yoganshbhalla/payl_theseus_2026/HARVEST/Readme.md

HARVEST PCB - See https://www.notion.so/uqspace/P-RV2601-HARVEST-301f47d1887680268325e2c343eff568
