yoganshbhalla/payl_theseus_2026/RILC/Readme.md

Regolith Illumination for Light-based Characterisation
Extension Board for AS7331 and AS7343 Breakout Spectrometers, containing VIS, UV, NIR LEDs and control/driver circuitry.
