yoganshbhalla/payl_theseus_2026/RILC/HARVEST_RILC_ExtBoard.kicad_pcb

## KiCad design RILC/HARVEST_RILC_ExtBoard.kicad_pcb (2026-03-03)

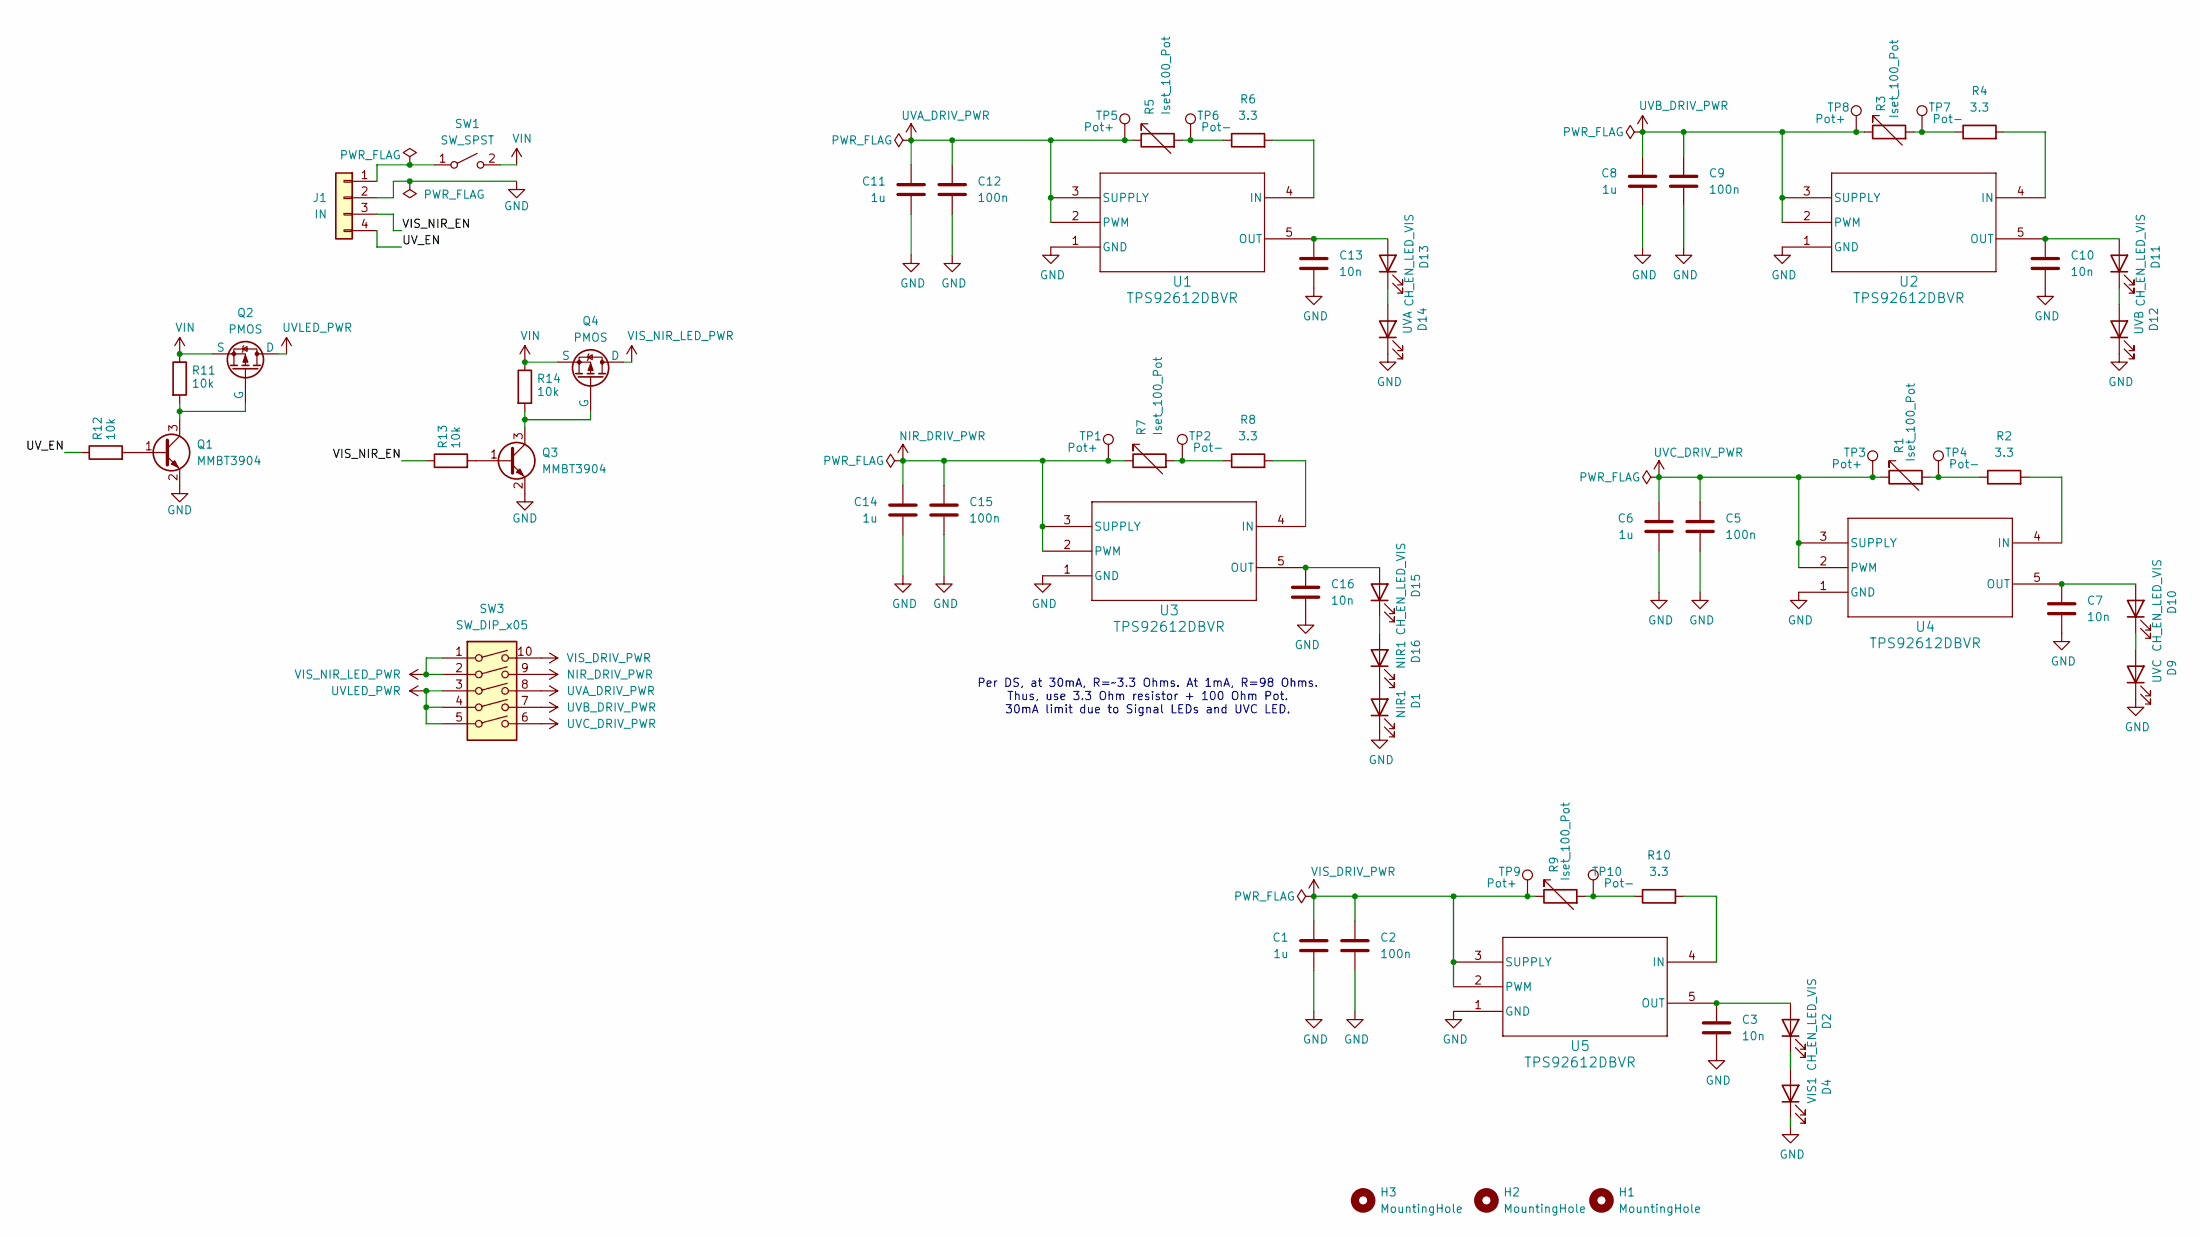
[picture p1: schematic HARVEST_RILC_ExtBoard.kicad_sch, HARVEST RILC (Reflectance Illumination LED Control) Extensi…]

Parts:
C1, C6, C8, C11, C14: 1u; C_0805_2012Metric_Pad1.18x1.45mm_HandSolder
C2, C5, C9, C12, C15: 100n; C_0805_2012Metric_Pad1.18x1.45mm_HandSolder
C3, C7, C10, C13, C16: 10n; C_0805_2012Metric_Pad1.18x1.45mm_HandSolder
D1, D16: NIR1; LED_0805_2012Metric_Pad1.15x1.40mm_HandSolder
D2, D10, D11, D13, D15: CH_EN_LED_VIS; LED_0805_2012Metric_Pad1.15x1.40mm_HandSolder
D4: VIS1; WL-SWTP_3014
D9: UVC; CR_0-275-120_VIS
D12: UVB; CHIP_1GF1A_SVI
D14: UVA; LED_0606
H1, H2, H3: MountingHole; MountingHole_2.2mm_M2
J1: IN; JST_XH_B4B-XH-A_1x04_P2.50mm_Vertical
Q1, Q3: MMBT3904; SOT-23
Q2, Q4: PMOS; SOT91P240X110-3N_DMG2305UX-7
R1, R3, R5, R7, R9: Iset_100_Pot; Potentiometer_Bourns_3296W_Vertical
R2, R4, R6, R8, R10: 3.3; R_0805_2012Metric_Pad1.20x1.40mm_HandSolder
R11, R12, R13, R14: 10k; R_0805_2012Metric_Pad1.20x1.40mm_HandSolder
SW1: SW_SPST; Switch_Toggle_SPDT_ANT11SF1CQE
SW3: SW_DIP_x05; SW_DIP_SPSTx05_Piano_CTS_Series194-5MSTN_W7.62mm_P2.54mm
TP1, TP3, TP5, TP8, TP9: Pot+; TestPoint_Pad_1.5x1.5mm
TP2, TP4, TP6, TP7, TP10: Pot-; TestPoint_Pad_1.5x1.5mm
U1, U2, U3, U4, U5: TPS92612DBVR; SOT_12DBVR_TEX

Connections:
/UV_EN: J1.4, R12.1
/VIS_NIR_EN: J1.3, R13.1
GND: C1.2, C2.2, C3.2, C5.2, C6.2, C7.2, C8.2, C9.2, C10.2, C11.2, C12.2, C13.2, C14.2, C15.2, C16.2, D1.1 (K), D4.1 (K), D9.1 (K), D12.1 (K), D14.1 (K), J1.2, Q1.2 (E), Q3.2 (E), U1.1 (GND), U2.1 (GND), U3.1 (GND), U4.1 (GND), U5.1 (GND)
NIR_DRIV_PWR: C14.1, C15.1, R7.1, SW3.9, TP1.1, U3.2 (PWM), U3.3 (SUPPLY)
unnamed: D1.2 (A), D16.1 (K)
unnamed: C3.1, D2.2 (A), U5.5 (OUT)
unnamed: D2.1 (K), D4.2 (A)
unnamed: C7.1, D10.2 (A), U4.5 (OUT)
unnamed: D9.2 (A), D10.1 (K)
unnamed: C10.1, D11.2 (A), U2.5 (OUT)
unnamed: D11.1 (K), D12.2 (A)
unnamed: C13.1, D13.2 (A), U1.5 (OUT)
unnamed: D13.1 (K), D14.2 (A)
unnamed: C16.1, D15.2 (A), U3.5 (OUT)
unnamed: D15.1 (K), D16.2 (A)
unnamed: J1.1, SW1.1 (A)
unnamed: Q1.1 (B), R12.2
unnamed: Q1.3 (C), Q2.2 (G), R11.2
unnamed: Q3.1 (B), R13.2
unnamed: Q3.3 (C), Q4.2 (G), R14.2
unnamed: R1.2, R2.1, TP4.1
unnamed: R3.2, R4.1, TP7.1
unnamed: R5.2, R6.1, TP6.1
unnamed: R7.2, R8.1, TP2.1
unnamed: R9.2, R10.1, TP10.1
unnamed: R6.2, U1.4 (IN)
unnamed: R4.2, U2.4 (IN)
unnamed: R8.2, U3.4 (IN)
unnamed: R2.2, U4.4 (IN)
unnamed: R10.2, U5.4 (IN)
UVA_DRIV_PWR: C11.1, C12.1, R5.1, SW3.8, TP5.1, U1.2 (PWM), U1.3 (SUPPLY)
UVB_DRIV_PWR: C8.1, C9.1, R3.1, SW3.7, TP8.1, U2.2 (PWM), U2.3 (SUPPLY)
UVC_DRIV_PWR: C5.1, C6.1, R1.1, SW3.6, TP3.1, U4.2 (PWM), U4.3 (SUPPLY)
UVLED_PWR: Q2.1 (D), SW3.3, SW3.4, SW3.5
VIN: Q2.3 (S), Q4.3 (S), R11.1, R14.1, SW1.2 (B)
VIS_DRIV_PWR: C1.1, C2.1, R9.1, SW3.10, TP9.1, U5.2 (PWM), U5.3 (SUPPLY)
VIS_NIR_LED_PWR: Q4.1 (D), SW3.1, SW3.2

Notes on the sheet:
Per DS, at 30mA, R=~3.3 Ohms. At 1mA, R=98 Ohms. Thus, use 3.3 Ohm resistor + 100 Ohm Pot. 30mA limit due to Signal LEDs and UVC LED.

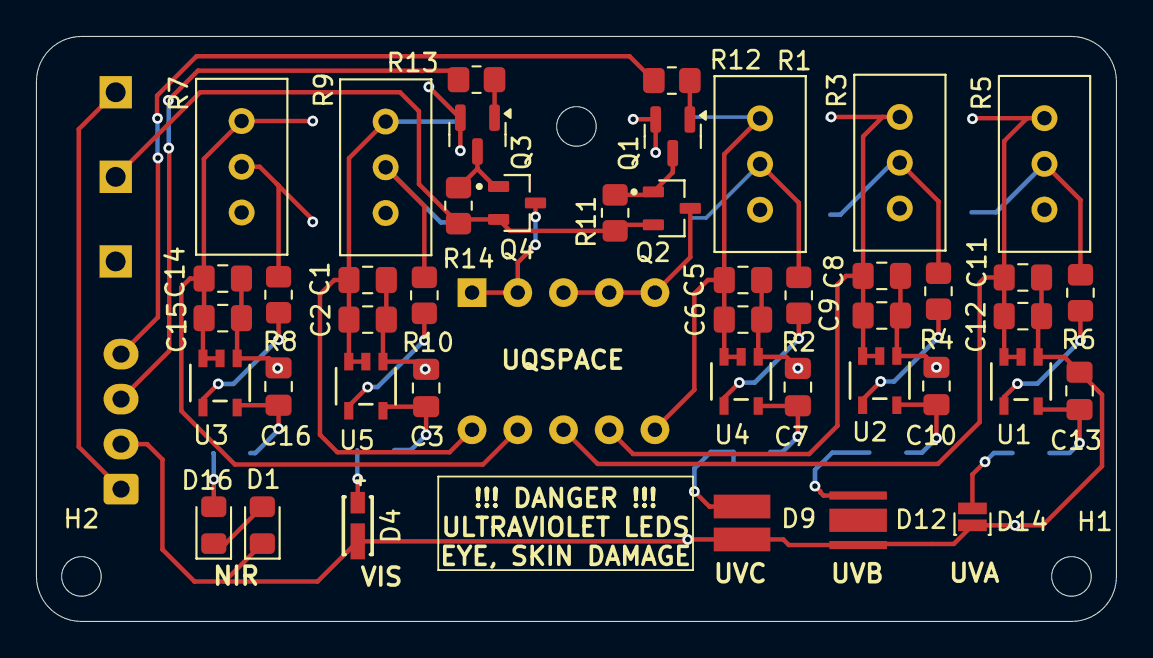
[picture p2: board HARVEST_RILC_ExtBoard.kicad_pcb from above]

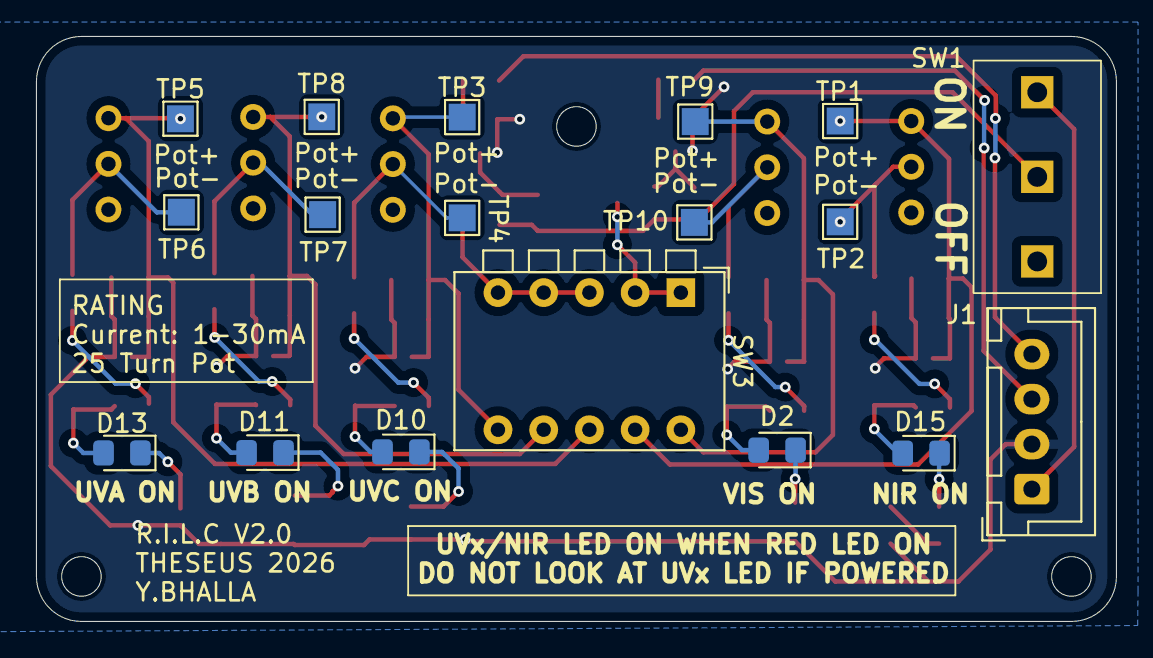
[picture p3: board HARVEST_RILC_ExtBoard.kicad_pcb from below]

Board: 2 copper layers, 60.0 x 32.5 mm, 65 parts (18 on the bottom side), 37 nets.
