yoganshbhalla/payl_theseus_2026/HARVEST/UQS_Theseus_HARVEST_Control_Boad.kicad_pcb

## KiCad design HARVEST/UQS_Theseus_HARVEST_Control_Boad.kicad_pcb (2026-03-03)

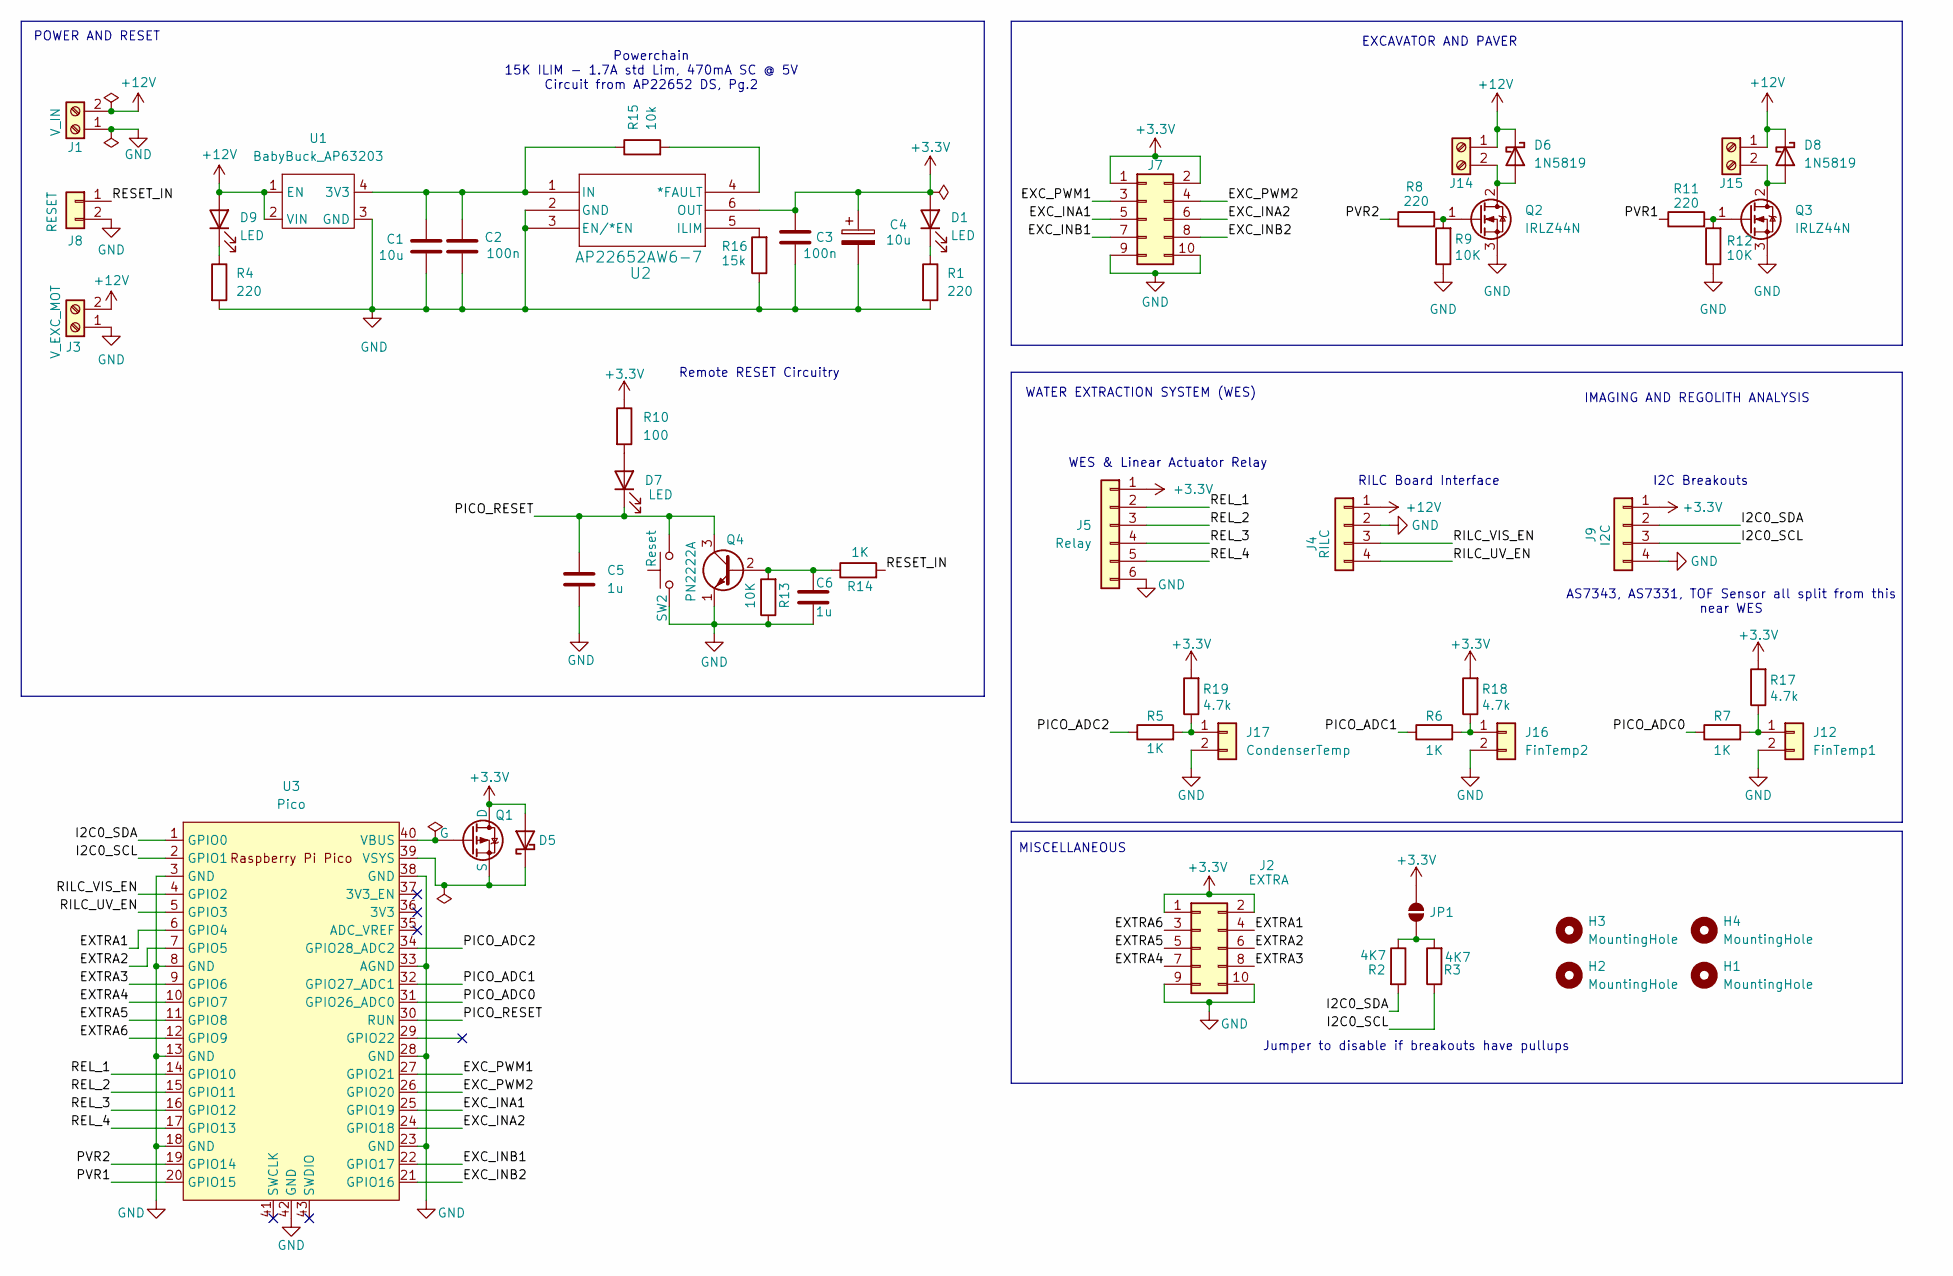
[picture p4: schematic UQS_Theseus_HARVEST_Control_Boad.kicad_sch, UQS H.A.R.V.E.S.T PCB]

Parts:
C1: 10u; C_0805_2012Metric_Pad1.18x1.45mm_HandSolder
C2, C3: 100n; C_0805_2012Metric_Pad1.18x1.45mm_HandSolder
C4: 10u; CP_Radial_D6.3mm_P2.50mm
C5, C6: 1u; C_0805_2012Metric_Pad1.18x1.45mm_HandSolder
D1, D7, D9: LED; LED_0805_2012Metric_Pad1.15x1.40mm_HandSolder
D5: D_Schottky; D_0805_2012Metric_Pad1.15x1.40mm_HandSolder
D6, D8: 1N5819; D_DO-41_SOD81_P10.16mm_Horizontal
H1, H2, H3, H4: MountingHole; MountingHole_3.2mm_M3
J1: V_IN; AMASS_XT30U-M_1x02_P5.0mm_Vertical
J2: EXTRA; PinHeader_2x05_P2.54mm_Vertical
J3: V_EXC_MOT; AMASS_XT30U-M_1x02_P5.0mm_Vertical
J4: RILC; JST_XH_B4B-XH-A_1x04_P2.50mm_Vertical
J5: Relay; JST_XH_B6B-XH-A_1x06_P2.50mm_Vertical
J7: MotorDriverSig; PinHeader_2x05_P2.54mm_Vertical
J8: RESET; PinHeader_1x02_P2.54mm_Vertical
J9: I2C; JST_XH_B4B-XH-A_1x04_P2.50mm_Vertical
J12: FinTemp1; JST_XH_B2B-XH-A_1x02_P2.50mm_Vertical
J14, J15: Screw_Terminal_01x02; TerminalBlock_RND_205-00012_1x02_P5.00mm_Horizontal
J16: FinTemp2; JST_XH_B2B-XH-A_1x02_P2.50mm_Vertical
J17: CondenserTemp; JST_XH_B2B-XH-A_1x02_P2.50mm_Vertical
JP1: SolderJumper_2_Open; SolderJumper-2_P1.3mm_Open_RoundedPad1.0x1.5mm
Q1: PMOS; SOT91P240X110-3N_DMG2305UX-7
Q2, Q3: IRLZ44N; TO-220-3_Vertical
Q4: PN2222A; TO-92_Inline
R1, R4, R8, R11: 220; R_0805_2012Metric_Pad1.20x1.40mm_HandSolder
R2, R3: 4K7; R_0805_2012Metric_Pad1.20x1.40mm_HandSolder
R5, R6, R7, R14: 1K; R_0805_2012Metric_Pad1.20x1.40mm_HandSolder
R9, R12, R13: 10K; R_0805_2012Metric_Pad1.20x1.40mm_HandSolder
R10: 100; R_0805_2012Metric_Pad1.20x1.40mm_HandSolder
R15: 10k; R_0805_2012Metric_Pad1.20x1.40mm_HandSolder
R16: 15k; R_0805_2012Metric_Pad1.20x1.40mm_HandSolder
R17, R18, R19: 4.7k; R_0805_2012Metric_Pad1.20x1.40mm_HandSolder
SW2: Reset; SW_PUSH_6mm_H4.3mm
U1: BabyBuck_AP63203; PinHeader_1x04_P2.54mm_Vertical
U2: AP22652AW6-7; AP22652A-M
U3: Pico; RPi_Pico_SMD_TH

Connections:
+3.3V: C3.1, C4.1, D1.2 (A), D5.2 (A), J2.1, J2.2, J5.1, J7.1, J7.2, J9.1, JP1.2 (B), Q1.1 (D), R10.1, R17.2, R18.2, R19.2, U2.6 (OUT)
+12V: D6.1 (K), D8.1 (K), D9.2 (A), J1.2, J3.2, J4.1, J14.1, J15.1, U1.1 (EN), U1.2 (VIN)
/EXC_INA1: J7.5, U3.25 (GPIO19)
/EXC_INA2: J7.6, U3.24 (GPIO18)
/EXC_INB1: J7.7, U3.22 (GPIO17)
/EXC_INB2: J7.8, U3.21 (GPIO16)
/EXC_PWM1: J7.3, U3.27 (GPIO21)
/EXC_PWM2: J7.4, U3.26 (GPIO20)
/EXTRA1: J2.4, U3.6 (GPIO4)
/EXTRA2: J2.6, U3.7 (GPIO5)
/EXTRA3: J2.8, U3.9 (GPIO6)
/EXTRA4: J2.7, U3.10 (GPIO7)
/EXTRA5: J2.5, U3.11 (GPIO8)
/EXTRA6: J2.3, U3.12 (GPIO9)
/I2C0_SCL: J9.3, R3.1, U3.2 (GPIO1)
/I2C0_SDA: J9.2, R2.2, U3.1 (GPIO0)
/PICO_ADC0: R7.1, U3.31 (GPIO26_ADC0)
/PICO_ADC1: R6.1, U3.32 (GPIO27_ADC1)
/PICO_ADC2: R5.1, U3.34 (GPIO28_ADC2)
/PICO_RESET: C5.1, D7.1 (K), Q4.3 (C), SW2.2, U3.30 (RUN)
/PVR1: R11.1, U3.20 (GPIO15)
/PVR2: R8.1, U3.19 (GPIO14)
/REL_1: J5.2, U3.14 (GPIO10)
/REL_2: J5.3, U3.15 (GPIO11)
/REL_3: J5.4, U3.16 (GPIO12)
/REL_4: J5.5, U3.17 (GPIO13)
/RESET_IN: J8.1, R14.2
/RILC_UV_EN: J4.4, U3.5 (GPIO3)
/RILC_VIS_EN: J4.3, U3.4 (GPIO2)
GND: C1.2, C2.2, C3.2, C4.2, C5.2, C6.2, J1.1, J2.9, J2.10, J3.1, J4.2, J5.6, J7.9, J7.10, J8.2, J9.4, J12.2, J16.2, J17.2, Q2.3 (S), Q3.3 (S), Q4.1 (E), R1.2, R4.2, R9.1, R12.1, R13.1, R16.1, SW2.1, U1.3 (GND), U2.2 (GND), U2.3 (EN/*EN), U3.3 (GND), U3.8 (GND), U3.13 (GND), U3.18 (GND), U3.23 (GND), U3.28 (GND), U3.33 (AGND), U3.38 (GND), U3.42 (GND)
unnamed: D1.1 (K), R1.1
unnamed: D5.1 (K), Q1.3 (S), U3.39 (VSYS)
unnamed: D6.2 (A), J14.2, Q2.2 (D)
unnamed: D7.2 (A), R10.2
unnamed: D8.2 (A), J15.2, Q3.2 (D)
unnamed: D9.1 (K), R4.1
unnamed: J12.1, R7.2, R17.1
unnamed: J16.1, R6.2, R18.1
unnamed: J17.1, R5.2, R19.1
unnamed: JP1.1 (A), R2.1, R3.2
unnamed: Q1.2 (G), U3.40 (VBUS)
unnamed: Q2.1 (G), R8.2, R9.2
unnamed: Q3.1 (G), R11.2, R12.2
unnamed: C6.1, Q4.2 (B), R13.2, R14.1
unnamed: C1.1, C2.1, R15.1, U1.4 (3V3), U2.1 (IN)
unnamed: R15.2, U2.4 (*FAULT)
unnamed: R16.2, U2.5 (ILIM)

Notes on the sheet:
I2C Breakouts
Jumper to disable if breakouts have pullups
RILC Board Interface
POWER AND RESET
MISCELLANEOUS
Powerchain 15K ILIM - 1.7A std Lim, 470mA SC @ 5V Circuit from AP22652 DS, Pg.2
Remote RESET Circuitry
EXCAVATOR AND PAVER
AS7343, AS7331, TOF Sensor all split from this near WES
WATER EXTRACTION SYSTEM (WES)
IMAGING AND REGOLITH ANALYSIS
WES & Linear Actuator Relay

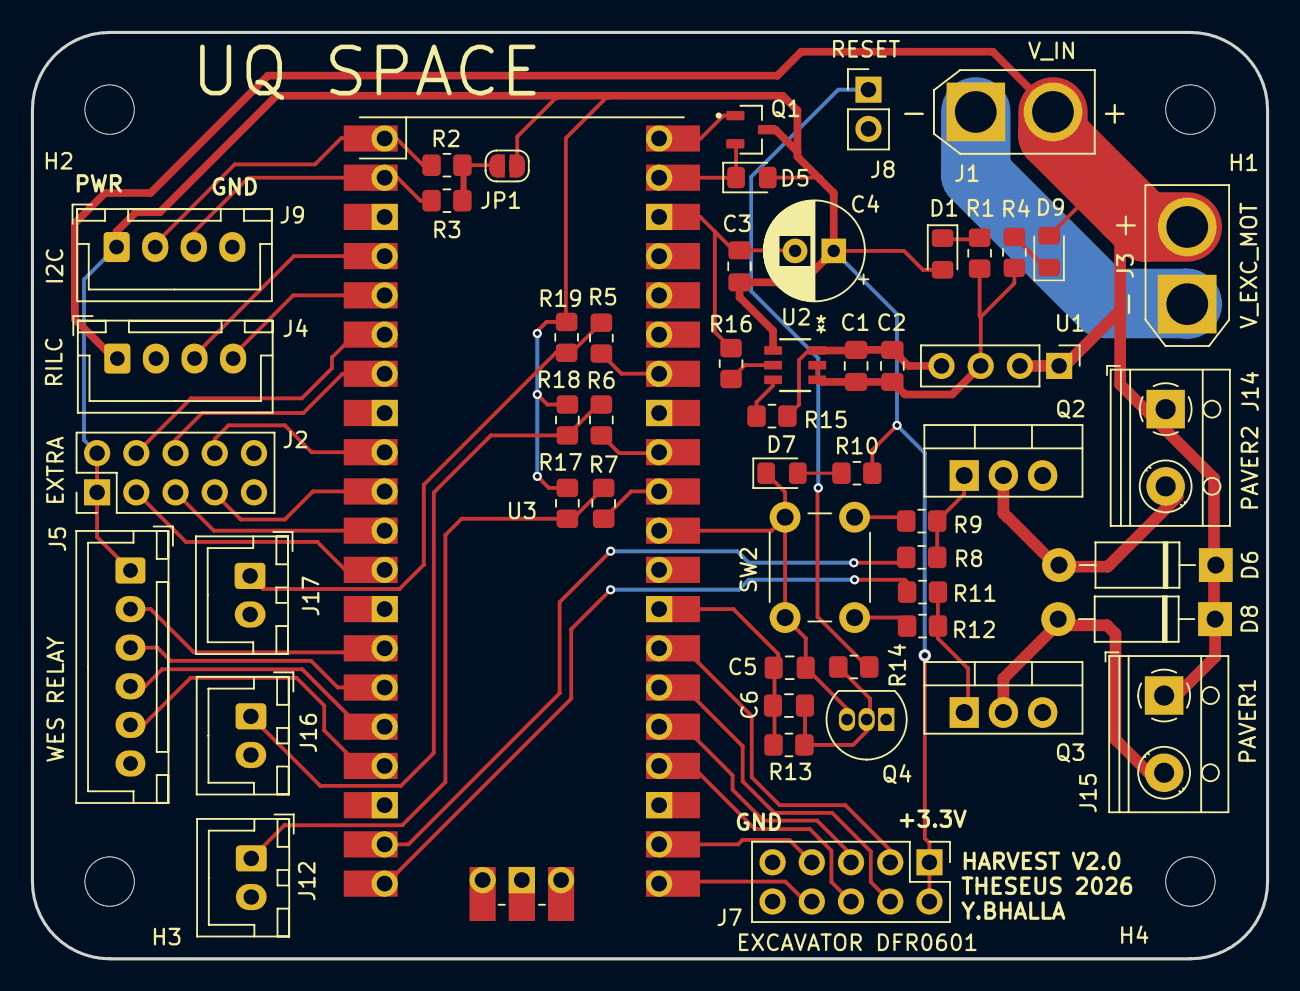
[picture p5: board UQS_Theseus_HARVEST_Control_Boad.kicad_pcb from above]

Board: 2 copper layers, 80.0 x 60.0 mm, 57 parts (0 on the bottom side), 47 nets.
