yoganshbhalla/payl_theseus_2026/(commit log)

2026-02-09 V1.1
    UV, NIR LEDS. Ready for Prod.
    [HARVEST_RILC_ExtBoard.kicad_pcb, HARVEST_RILC_ExtBoard.kicad_sch]
2026-03-03 V2.0: Added eFuse
    HARVEST V2; Added eFuse for SC, OCP, Reverse Prot. Finished Silkscreen and fixed all valid warnings/errors. Production variant if review passed.
    [UQS_Theseus_HARVEST_Control_Boad.kicad_pcb, UQS_Theseus_HARVEST_Control_Boad.kicad_sch]
2026-03-03 V2.0: Produced Version
    [HARVEST_RILC_ExtBoard.kicad_pcb, HARVEST_RILC_ExtBoard.kicad_sch]
